lewlev/AlarmProject/AlarmProject_SofwareFlow.pdf

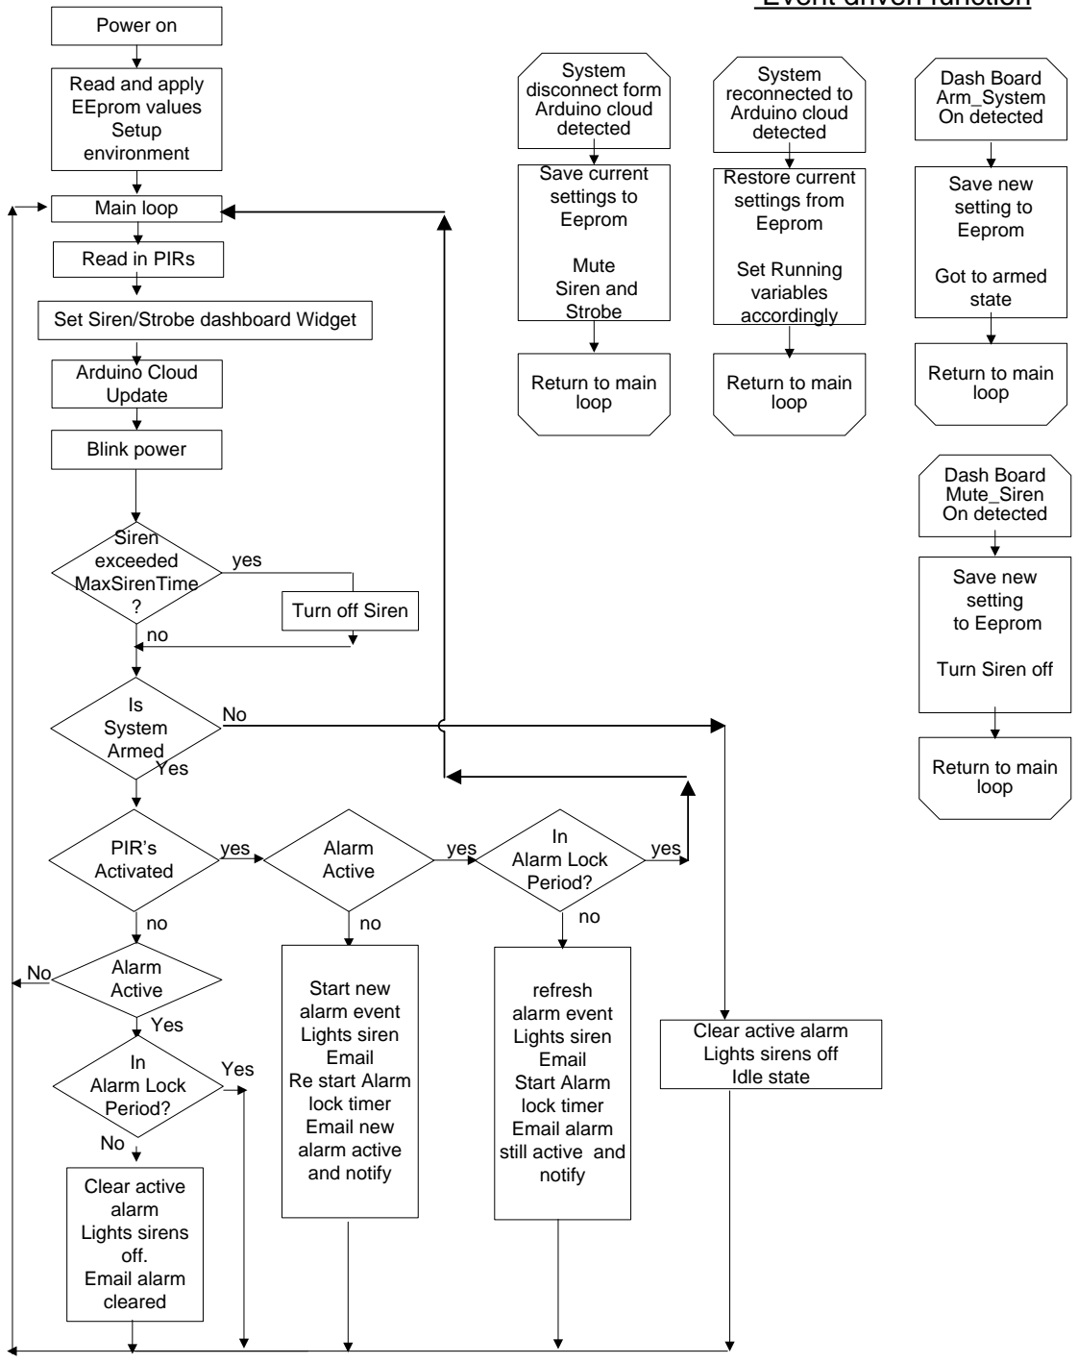
[picture p44: figure]
Power on Read and apply; EEprom values Setup environment; Siren exceeded; MaxSirenTime ?; Read in PIRs; Blink power; yes; Arduino Cloud Update; Turn off Siren; PIR’s Activated; Alarm Active; refresh alarm event; Lights siren Email; In Alarm Lock; Period?; Start new alarm event; Main loop; Is System Armed; Yes; Clear active alarm Lights sirens off; Idle state no; Yes No; System disconnect form Arduino cloud; detected; Save current settings to Eeprom; Mute Siren and; Strobe Return to main loop; System reconnected to Arduino cloud; Return to main loop; Dash Board Arm_System On detected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

Start Alarm lock timer Email alarm still active and notify

Re start Alarm lock timer Email new alarm active and notify

Clear active alarm Lights sirens off. Email alarm cleared

## Operation

There are effectively three inputs to the alarm system 1. Dash board System_Aarm switch, that switches alarm from the idle state to the armed state 2. Dash board Mute_Siren when on disables the siren. Logical state of the siren is not effected. 3. The sensor input (PIRs) these are logically just one input, If the system is in the armed state and any Sensor comes on an alarm will

be triggered. There are several built in software timers that determine system behaviour the durations are controlled by variables in the software at compile time. 1. When an alarm is triggered at timer starts that holds the system in the ‘Alarmed State’ until the timer expires or the system is disarmed. Variable AE_Hold sets the duration on the hold period. (default 10 minutes)

2. The duration the siren can sound is limited, for each alarm even, for regulatory and common sense reasons The MaxSireTime sets the duration.(default 180000ms) 3 minutes 3. In addition to timer 2 above there is a lock out period after the siren has stopped sounding until it can sound again. Variable Siren_Lockout sets the duration. (default 900000ms) 15 minutes.

## Asynchronous Event driven function

Restore current settings from Eeprom Set Running variables accordingly Save new setting to Eeprom Got to armed state

Dash Board
Arm_System Off detected

Save new settings to Eeprom Got to idle state

Return to main loop

Dash Board
Mute_Siren Off detected

Save new setting

to Eeprom Set Siren on or off accordingly

Return to main loop

## Software flow diagram
