lewlev/AlarmProject/Build/Alarm_Project_Mobile App installs.pdf

# Mobile app install screen shots from iPhone

# Arduino remote App

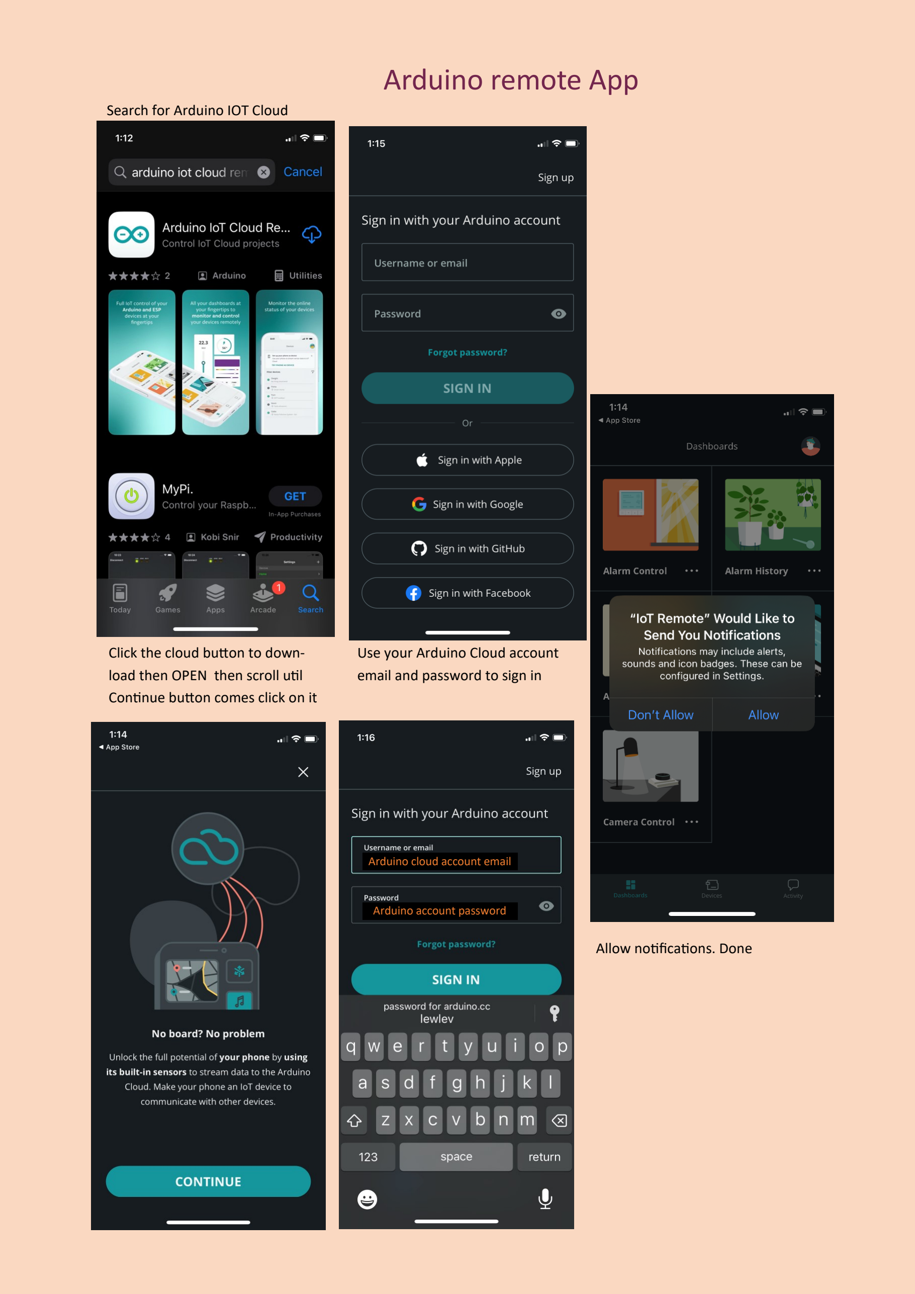
[picture p45: page 2]

Search for Arduino IOT Cloud

Click the cloud button to download then OPEN then scroll util Continue button comes click on it

Use your Arduino Cloud account email and password to sign in

Arduino cloud account email

Arduino account password

Allow notifications. Done

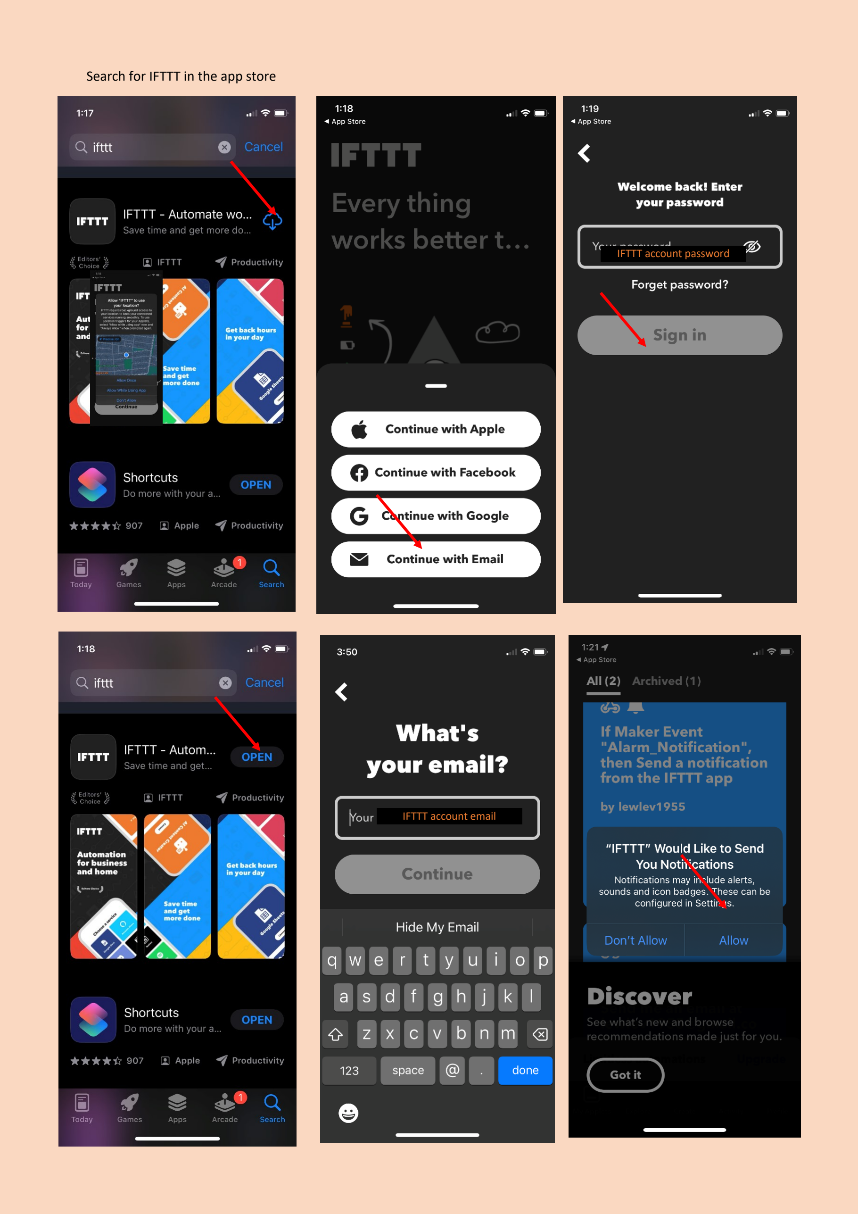
[picture p46: page 3]

IFTTT account email

IFTTT account password

Search for IFTTT in the app store

## Done

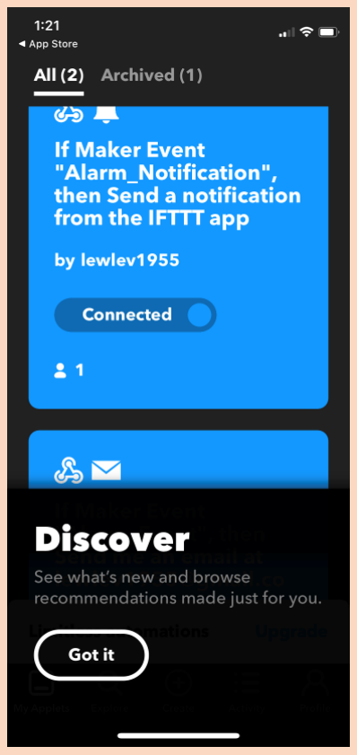
[picture p47: figure]
