lewlev/AlarmProject/Build/AlarmProject_Setting_PIR_Voltage_ref.pdf

# Old Alarm Panel P

I
R

1

S | C E | 0 N | M

P
I
R

2

C | S
O | E M | N

P
I
R

3

S | C E | 0 N | M

P
I
R

4

C | S
O | E M | N | EXT
SIREN + | C V | 0
M EXT STROBE + | C V | 0

M

INT

SIREN + | C V | 0
M | 12-14V DC

OUT

+ | C + | O + | M

# DVM

4.00v

# PIR

Testing the PIR

Measure the voltage when the PIR is clear Lets Say Vclear =1volt
Them measure the voltage when its activated Valarm = 4 volts

Software config

If Valarm is greater than Vclear
Then in the in the .ino file we need to leave #define AlarmHigh
If Vclear is the higher, then comment out // #define AlarmHigh

Calculate the reference voltage

Irrespective of which voltage is the higher
We need to set the reference voltage to be equal to the lower of the two readings plus half the difference between the readings. If say Vclear = 1volts

Valarm = 4 volts

Vref = 1+(4 – 1)/2 = 2.5volts. Leave | #define AlarmHigh
Or if | Vclear = 9volts
Valarm = 3 volts

Vref = 3+(9 – 3)/2 = 6.0volts. COMMENT // #define AlarmHigh

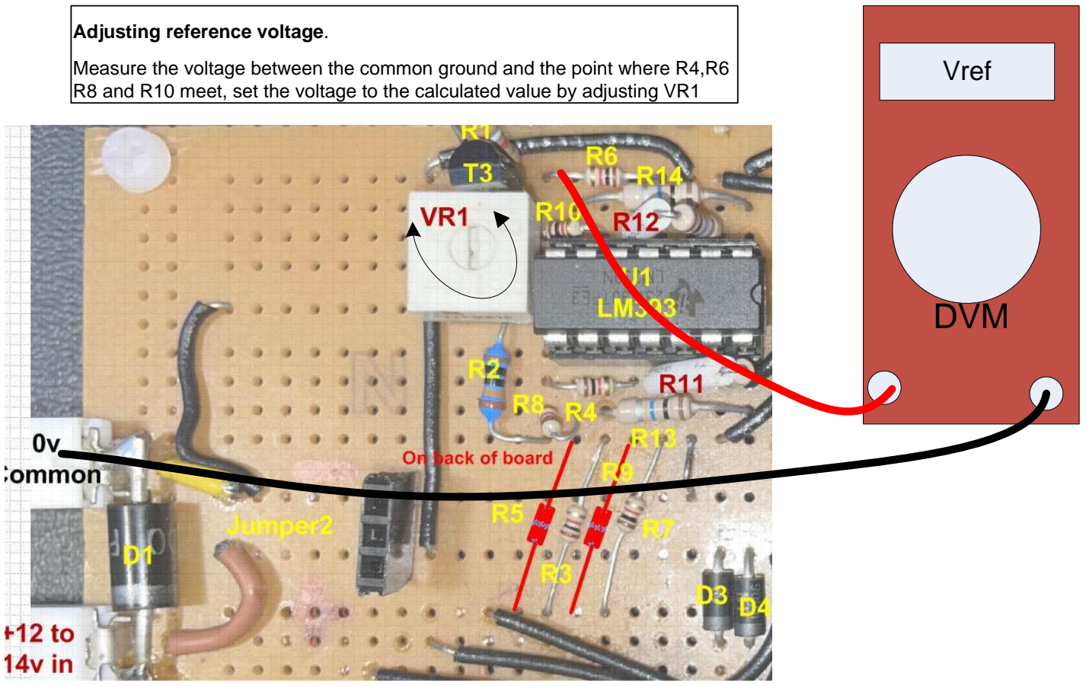
[picture p48: figure]
DVM; Vref

Adjusting reference voltage. Measure the voltage between the common ground and the point where R4,R6

R8 and R10 meet, set the voltage to the calculated value by adjusting VR1
