lewlev/AlarmProject/Build/IftttSetup.pdf

## Account Setup (free)

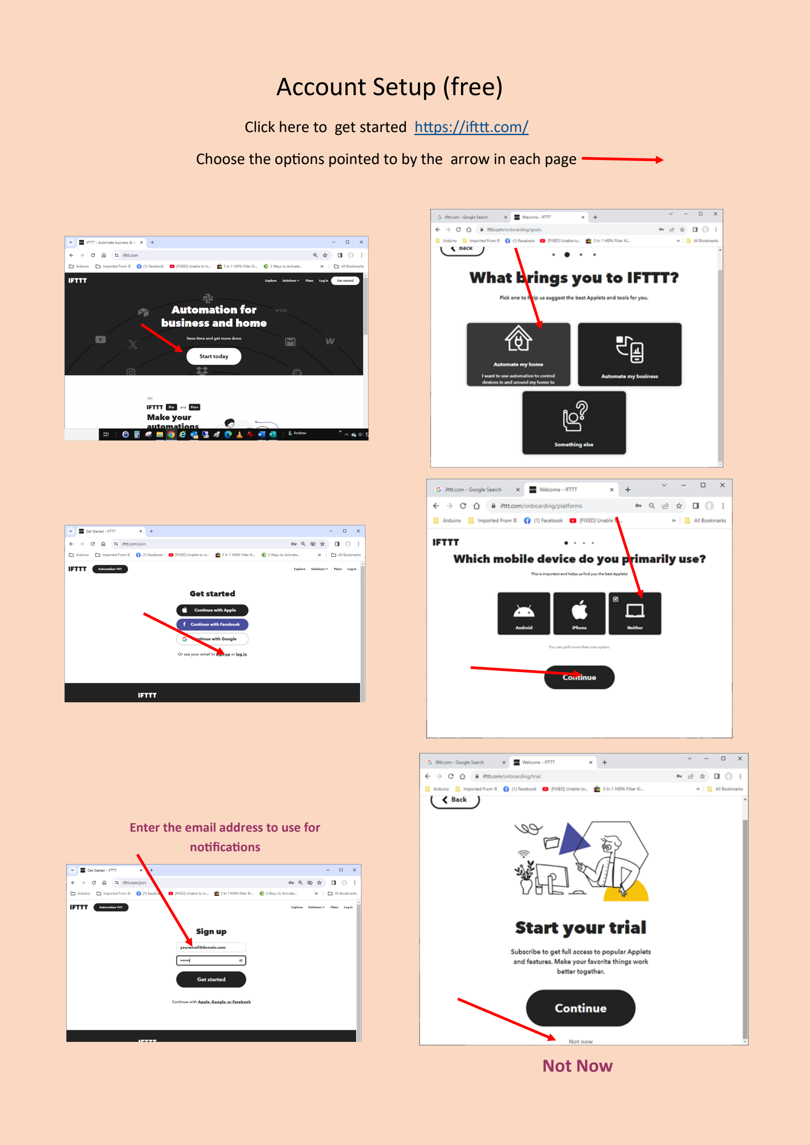
[picture p49: page 1]

Click here to get started https://ifttt.com/

Choose the options pointed to by the arrow in each page

Not Now

Enter the email address to use for notifications

## Get the connection key

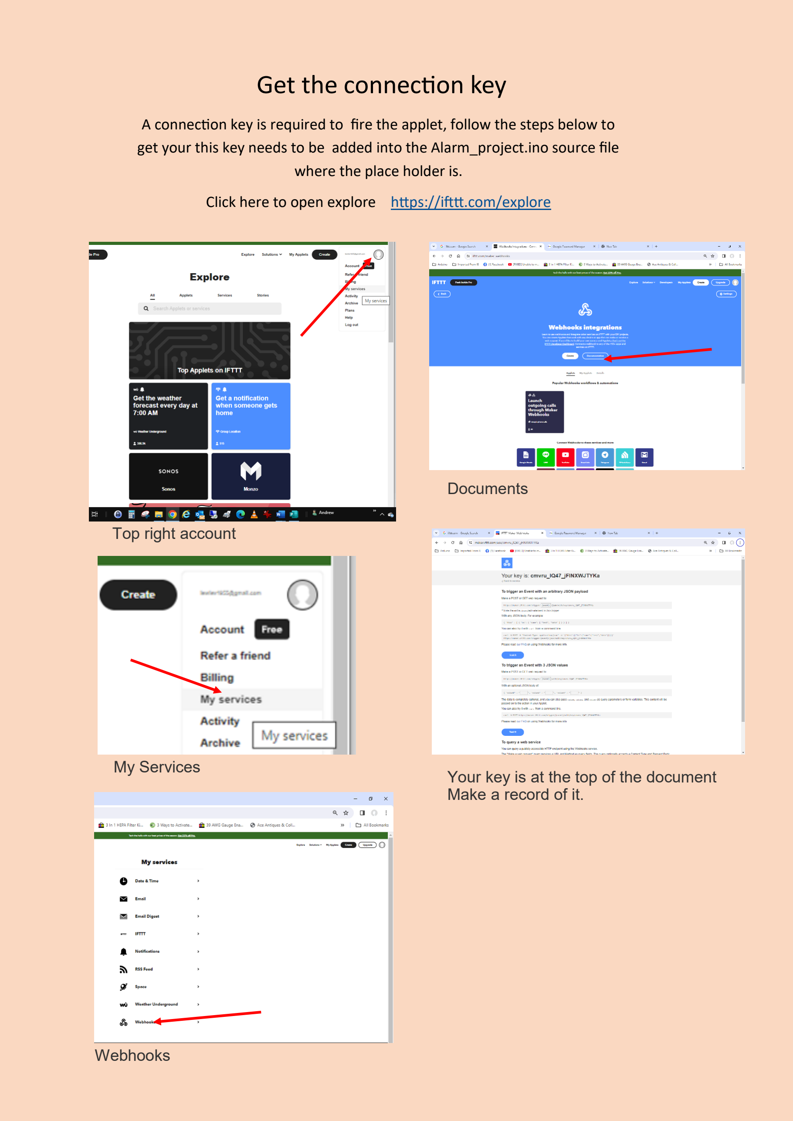
[picture p50: page 2]

Your key is at the top of the document Make a record of it.

A connection key is required to fire the applet, follow the steps below to get your this key needs to be added into the Alarm_project.ino source file where the place holder is.

Click here to open explore https://ifttt.com/explore

Top right account

My Services

Webhooks

Documents

## Create the Email Applete

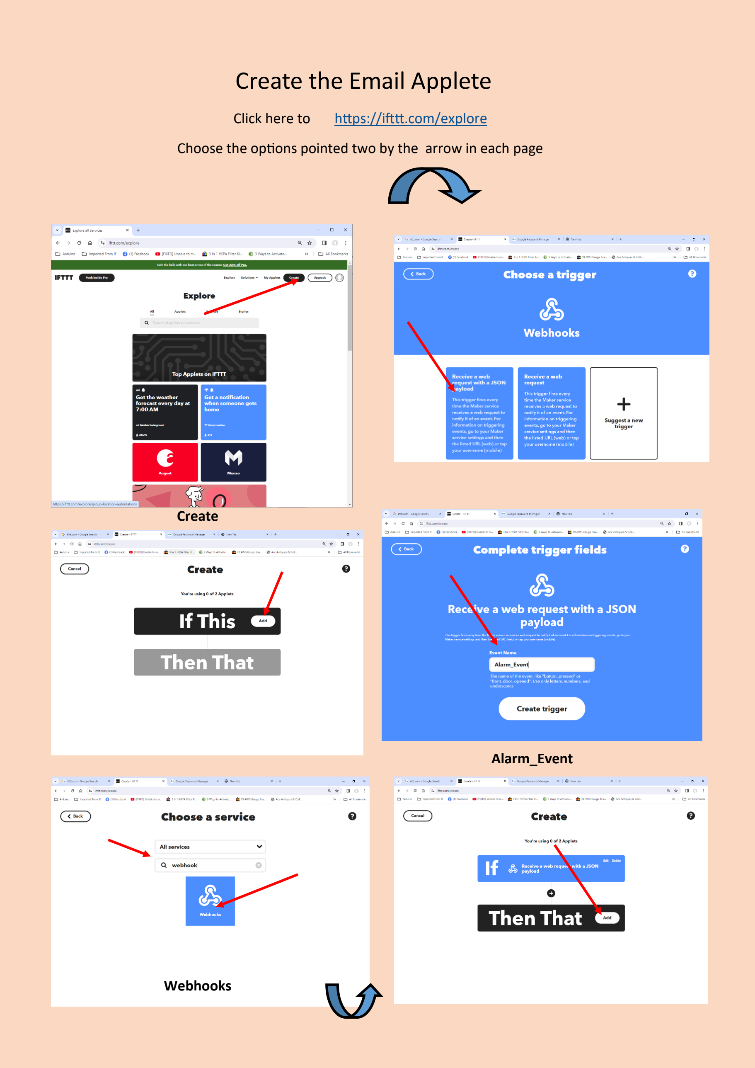
[picture p51: page 3]

Click here to https://ifttt.com/explore

Choose the options pointed two by the arrow in each page

Create

Alarm_Event

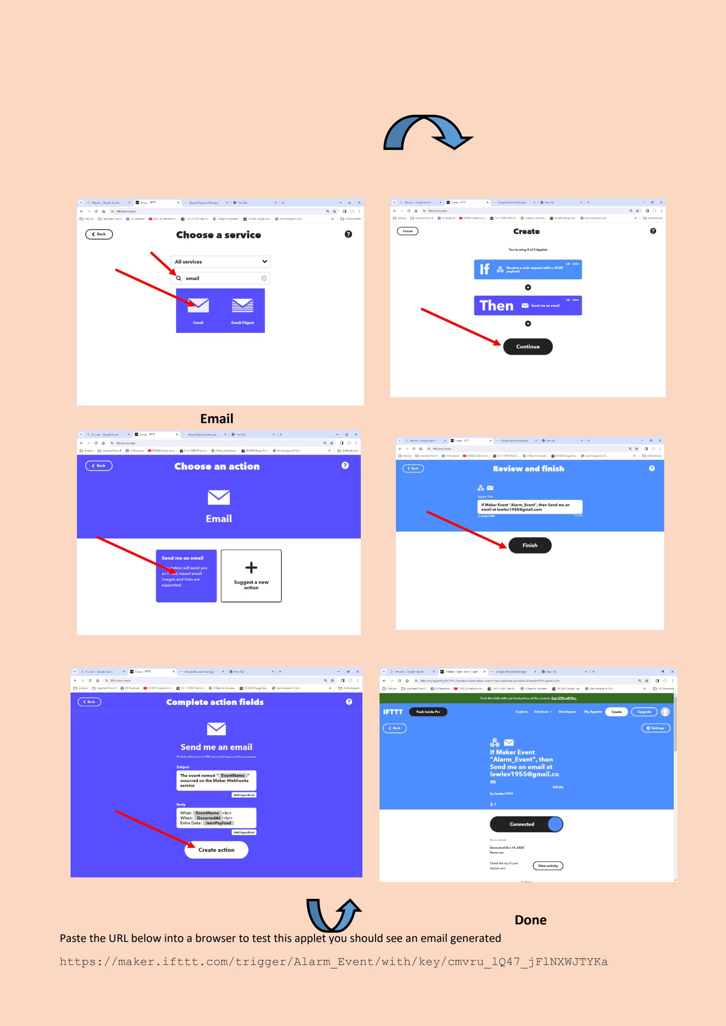
[picture p52: page 4]

Email

Done
Paste the URL below into a browser to test this applet you should see an email generated

https://maker.ifttt.com/trigger/Alarm_Event/with/key/cmvru_lQ47_jFlNXWJTYKa

## Create the Notification Applete

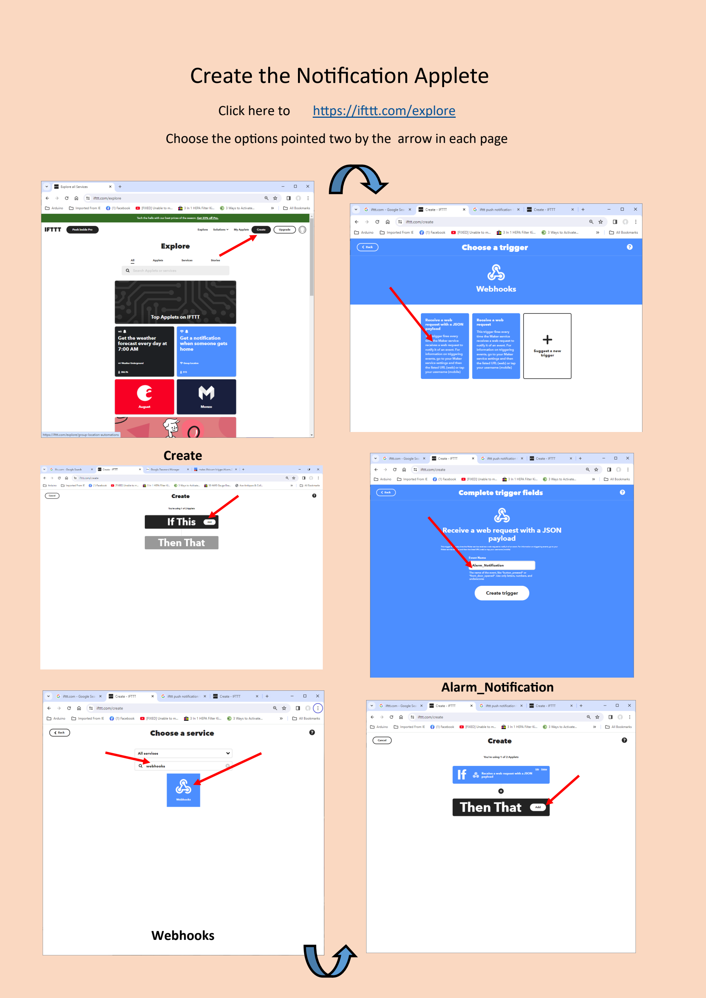
[picture p53: page 5]

Click here to https://ifttt.com/explore

Choose the options pointed two by the arrow in each page

Create

Alarm_Notification

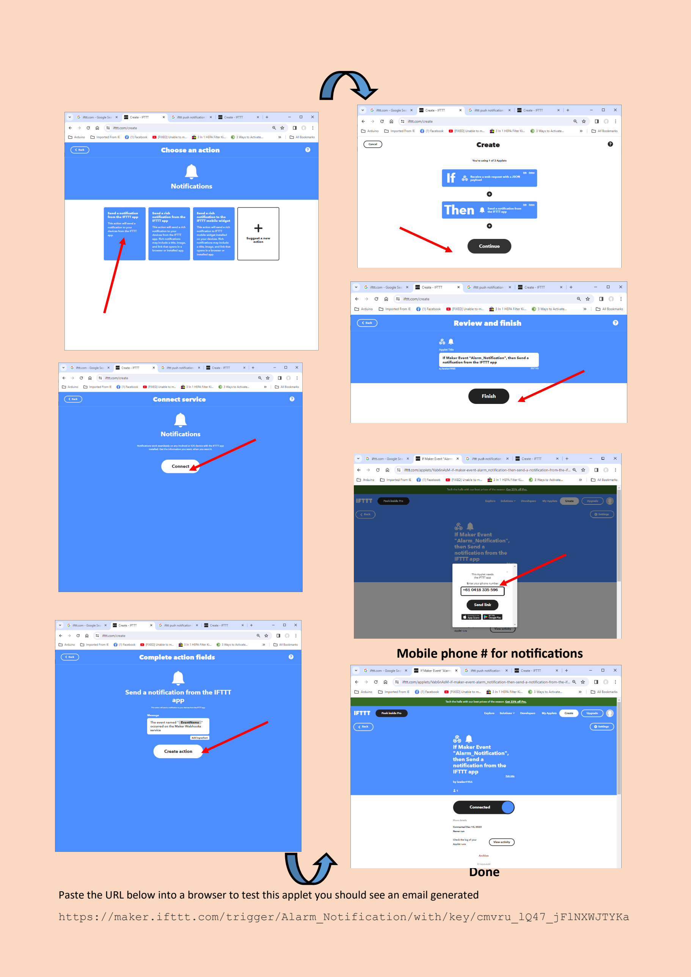
[picture p54: page 6]

Done

Mobile phone # for notifications

Paste the URL below into a browser to test this applet you should see an email generated

https://maker.ifttt.com/trigger/Alarm_Notification/with/key/cmvru_lQ47_jFlNXWJTYKa
