lewlev/AlarmProject/hardware/AlarmProject_CCT.pdf

V+ 13.6V

## Com

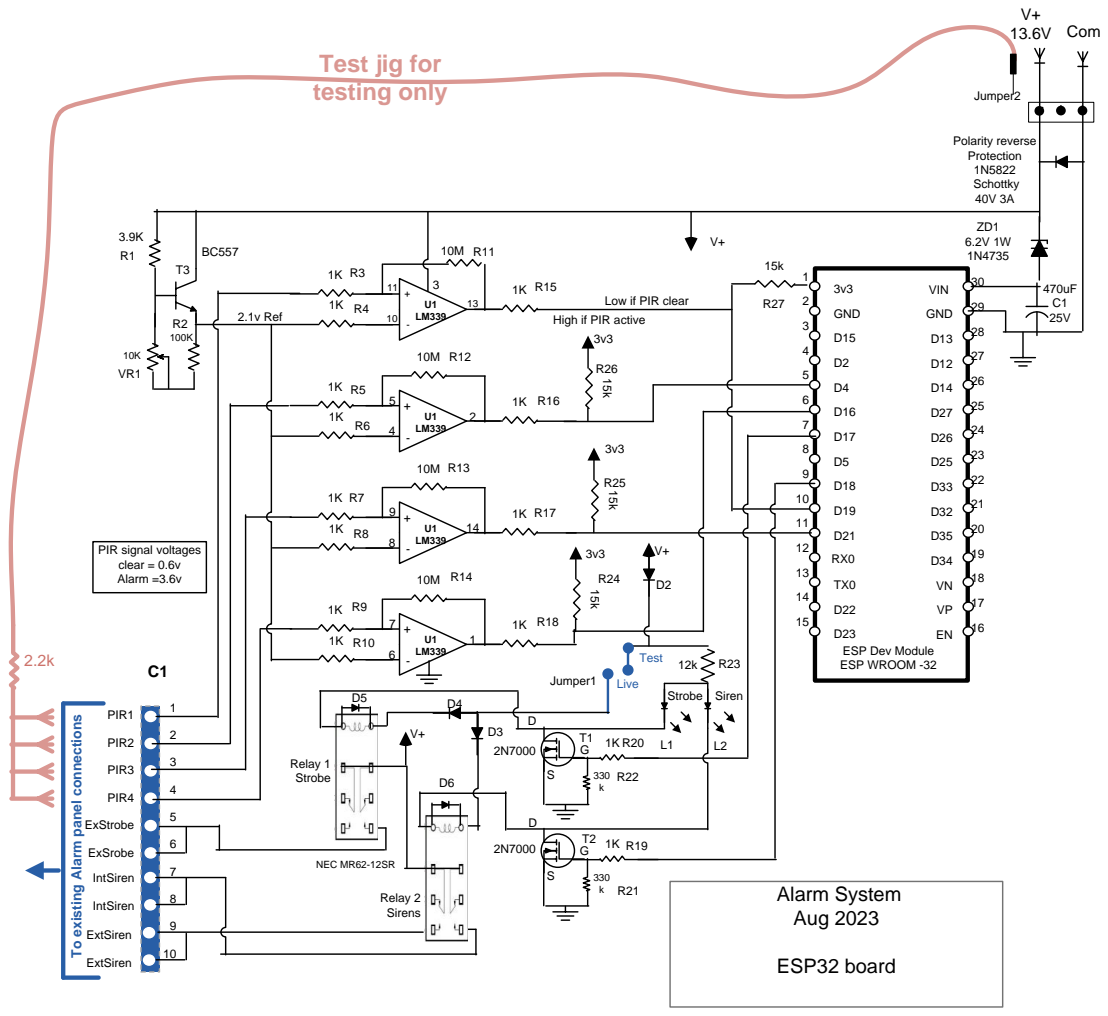
[picture p55: page 1]

Polarity reverse Protection 1N5822 Schottky 40V 3A

Low if PIR clear High if PIR active

PIR signal voltages clear = 0.6v Alarm =3.6v

ESP Dev Module ESP WROOM -32

To existing Alarm panel connections
