lewlev/AlarmProject/Build/Alarm_Project_Inter_Connect.pdf

# Old Alarm Panel P

# Wiring diagram

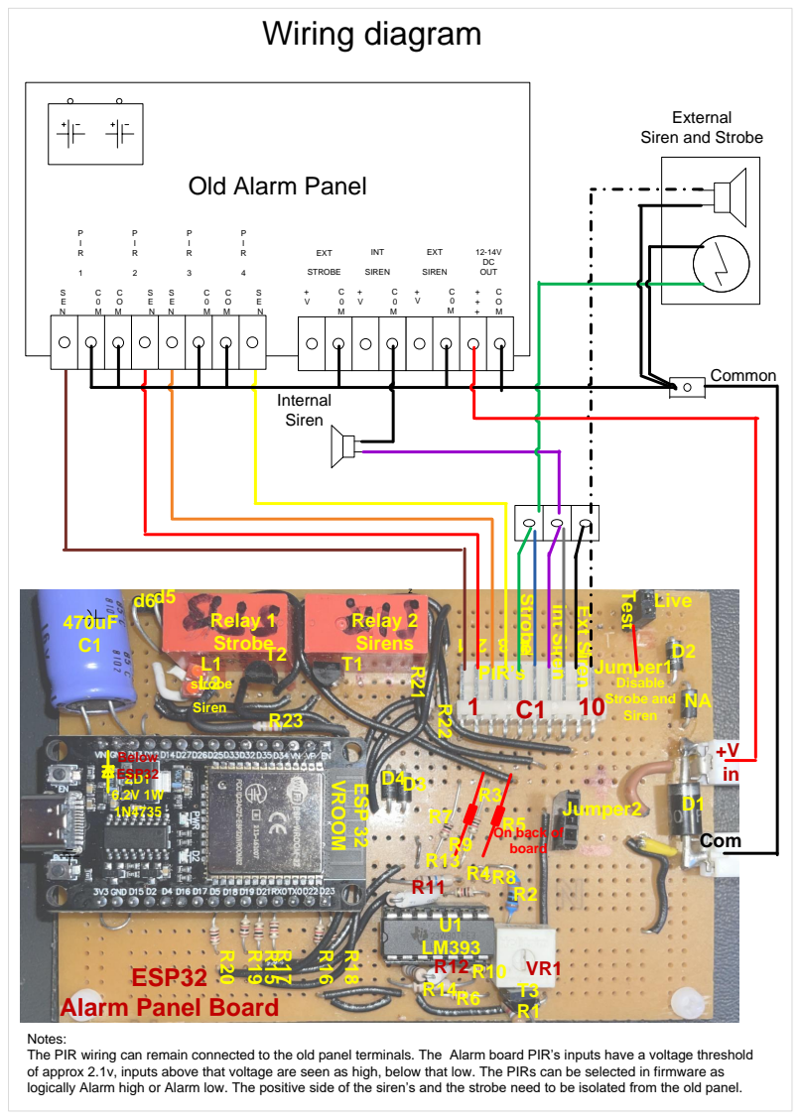
[picture p56: page 1]

Notes:
The PIR wiring can remain connected to the old panel terminals. The Alarm board PIR’s inputs have a voltage threshold
of approx 2.1v, inputs above that voltage are seen as high, below that low. The PIRs can be selected in firmware as
logically Alarm high or Alarm low. The positive side of the siren’s and the strobe need to be isolated from the old panel.
