lewlev/AlarmProject/hardware/AlarmProject_CCT_LAYOUT.pdf

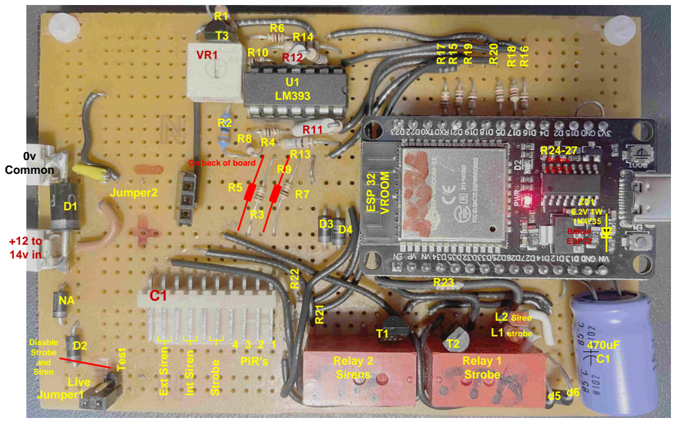
[picture p57: page 1]
